guykuo/Bunny-Science/BNB Universal Bear or Prusa x-carriage bottom cover short  (BNB9Si).stl

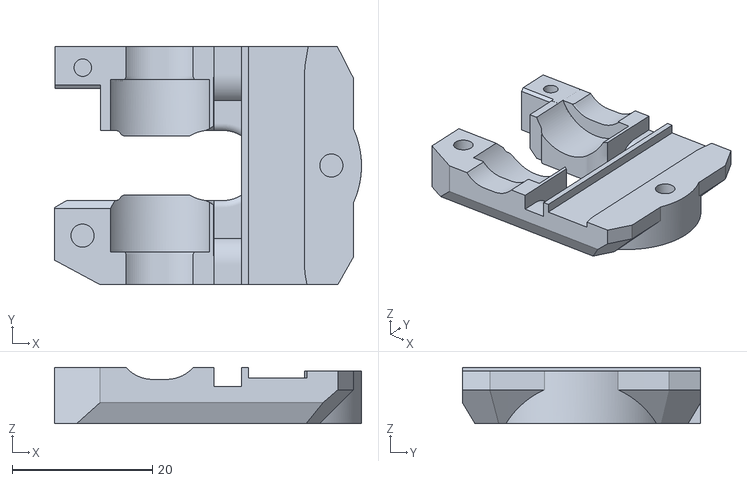
[picture p1: CAD file, 2019-09-02]
BNB Universal Bear or Prusa x-carriage bottom cover short (BNB9Si).stl
43.8 x 34.0 x 8.02
