guykuo/Bunny-Science/BNB Universal Bear or Prusa x-carriage (BNB9Si) plated.3mf

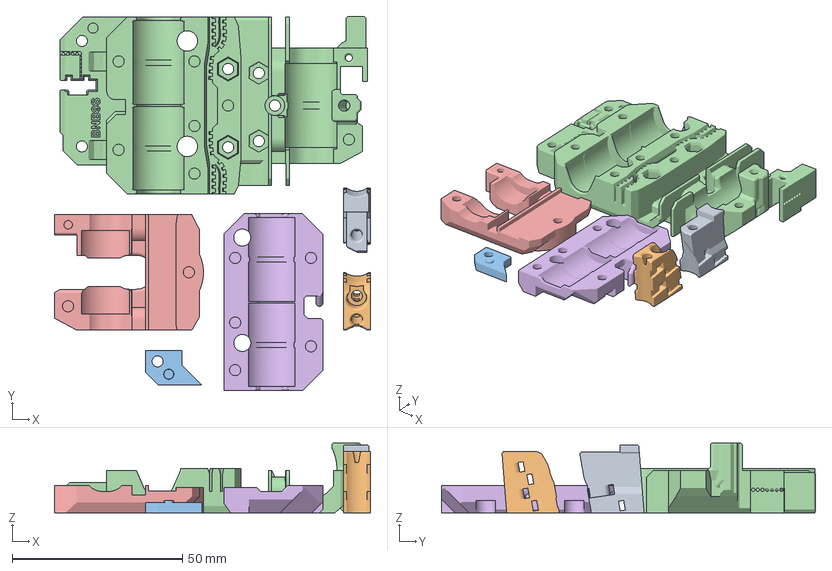
[picture p2: CAD file, 2019-09-02]
BNB Universal Bear or Prusa x-carriage (BNB9Si) plated.3mf
92.9 x 110.0 x 20.5 mm
part_a.stl
part_b.stl
BNBSX carriage screw spacer (BNB9S).stl
BNB universal x-carriage (BNB9S).stl
BNB Universal Bear or Prusa x-carriage bottom cover short (BNB9S) (1).stl
BNB Universal Bear or Prusa x-carriage top cover (BNB9Si).stl
