guykuo/Bunny-Science/BNB universal x-carriage (BNB9Si).stl

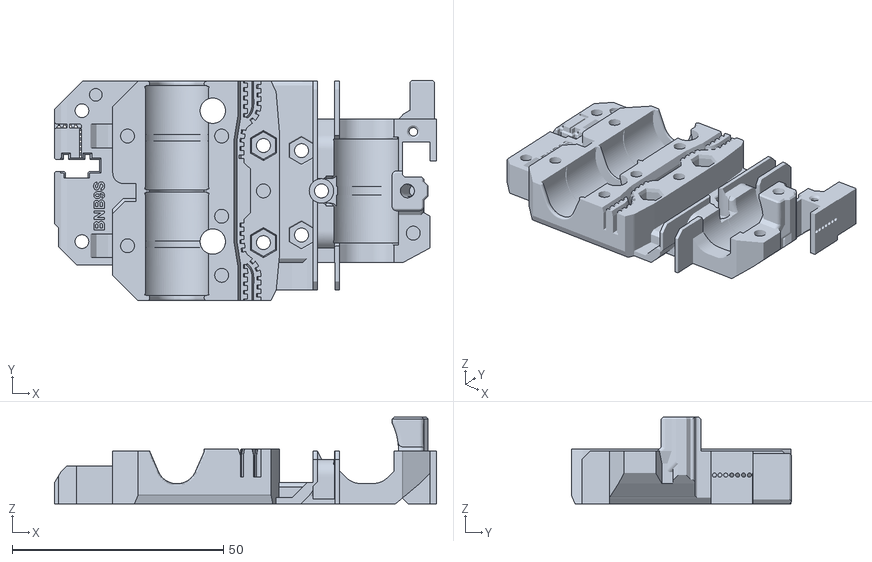
[picture p3: CAD file, 2019-09-02]
BNB universal x-carriage (BNB9Si).stl
90.5 x 52.2 x 20.5
