guykuo/Bunny-Science/BNB Universal Bear or Prusa x-carriage top cover (BNB9Si).stl

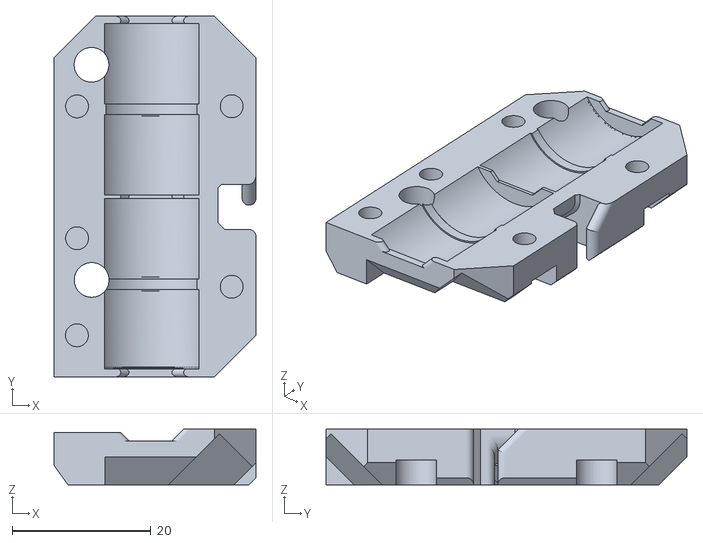
[picture p4: CAD file, 2019-09-02]
BNB Universal Bear or Prusa x-carriage top cover (BNB9Si).stl
29.1 x 52.0 x 8.00
