guykuo/Bunny-Science/BNB cable_guide_back_a.stl

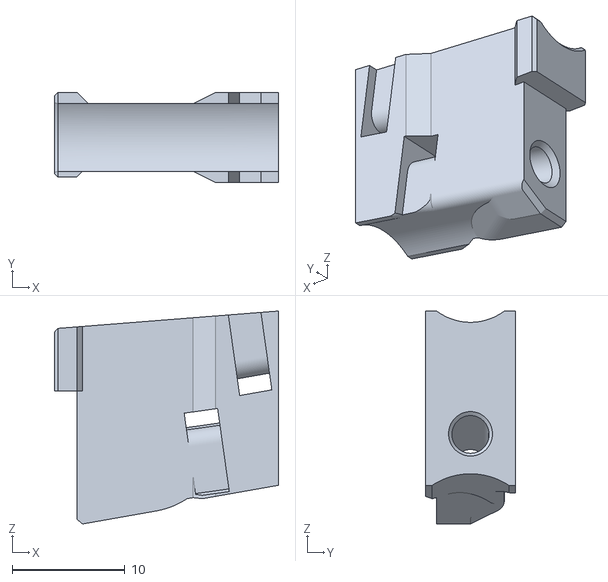
[picture p5: CAD file, 2019-08-01]
BNB cable_guide_back_a.stl
19.9 x 8.00 x 18.9
