guykuo/Bunny-Science/Bear cable_guide_back_b.stl

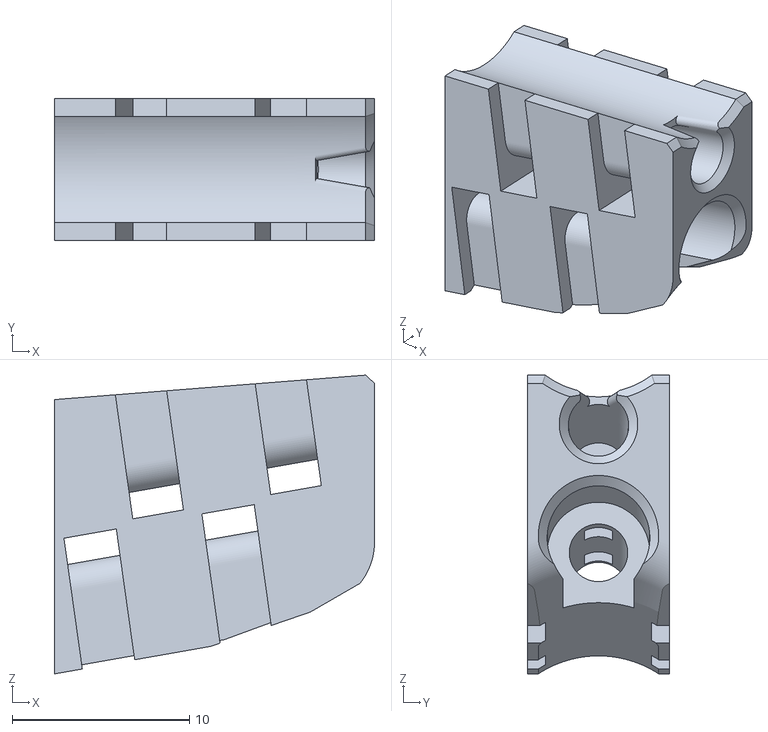
[picture p6: CAD file, 2019-08-01]
Bear cable_guide_back_b.stl
18.1 x 8.00 x 16.9
