guykuo/Bunny-Science/BNBSX carriage screw spacer (BNB9S).stl

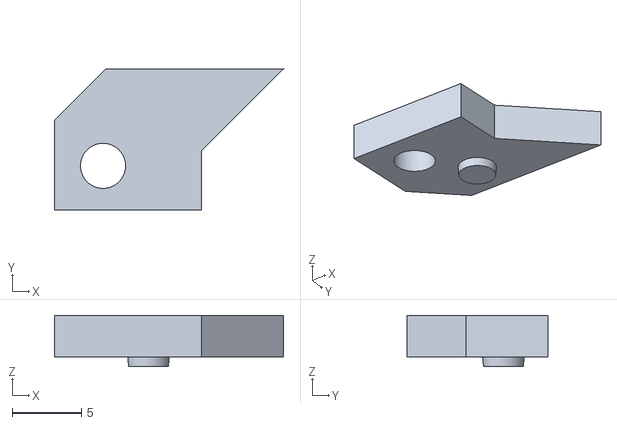
[picture p7: CAD file, 2019-08-01]
BNBSX carriage screw spacer (BNB9S).stl
16.5 x 10.2 x 3.70
